tooyipjee/batlistener/Bat_Listner_JLCPCB/mfg/Rev A/schematic.pdf

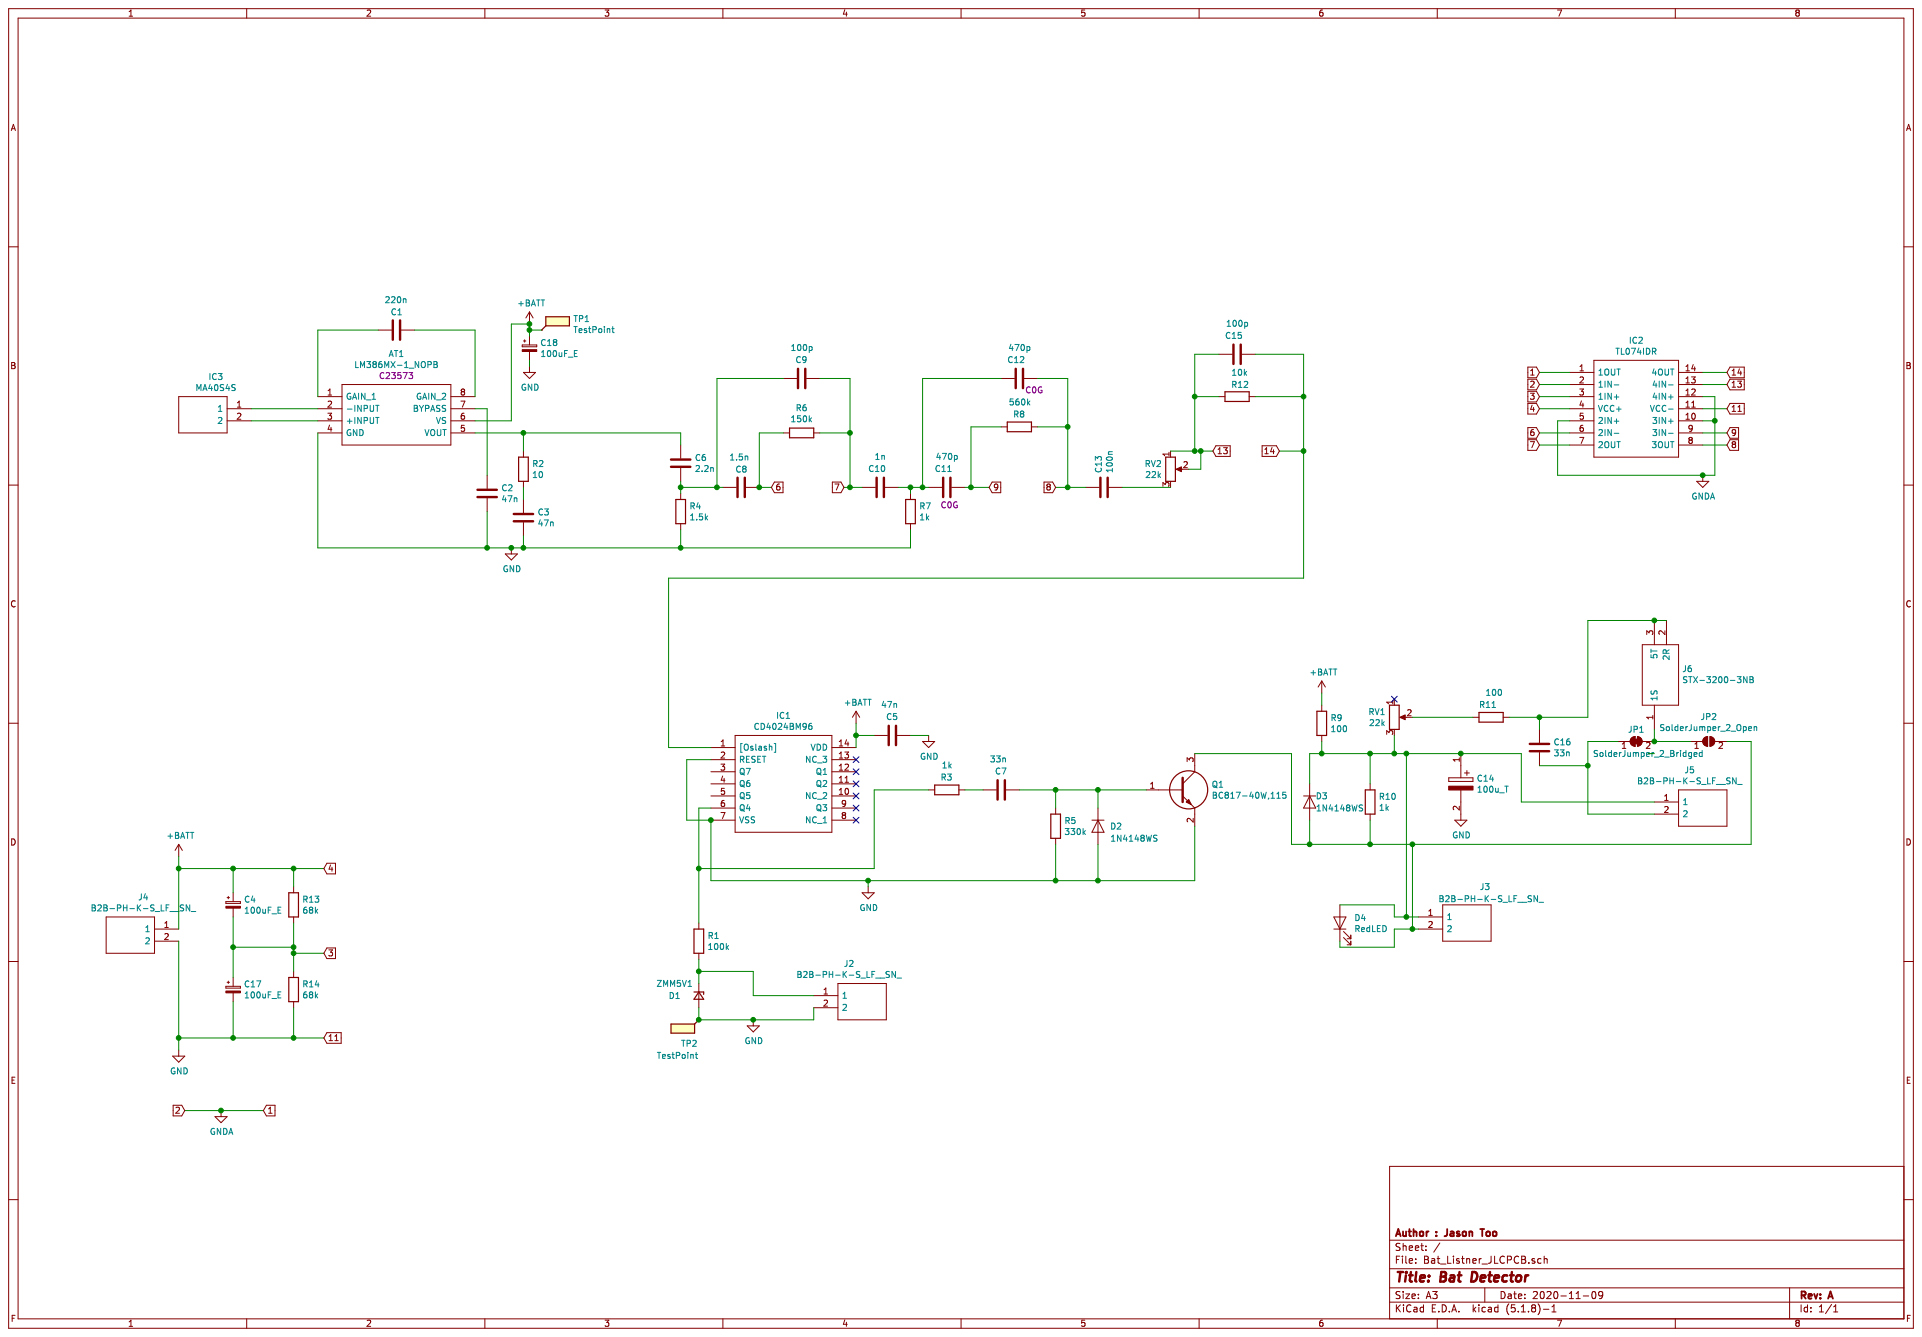
[picture p34: page 1]
