tooyipjee/batlistener/Bat_Listner_JLCPCB/mfg/Rev A/layout.pdf

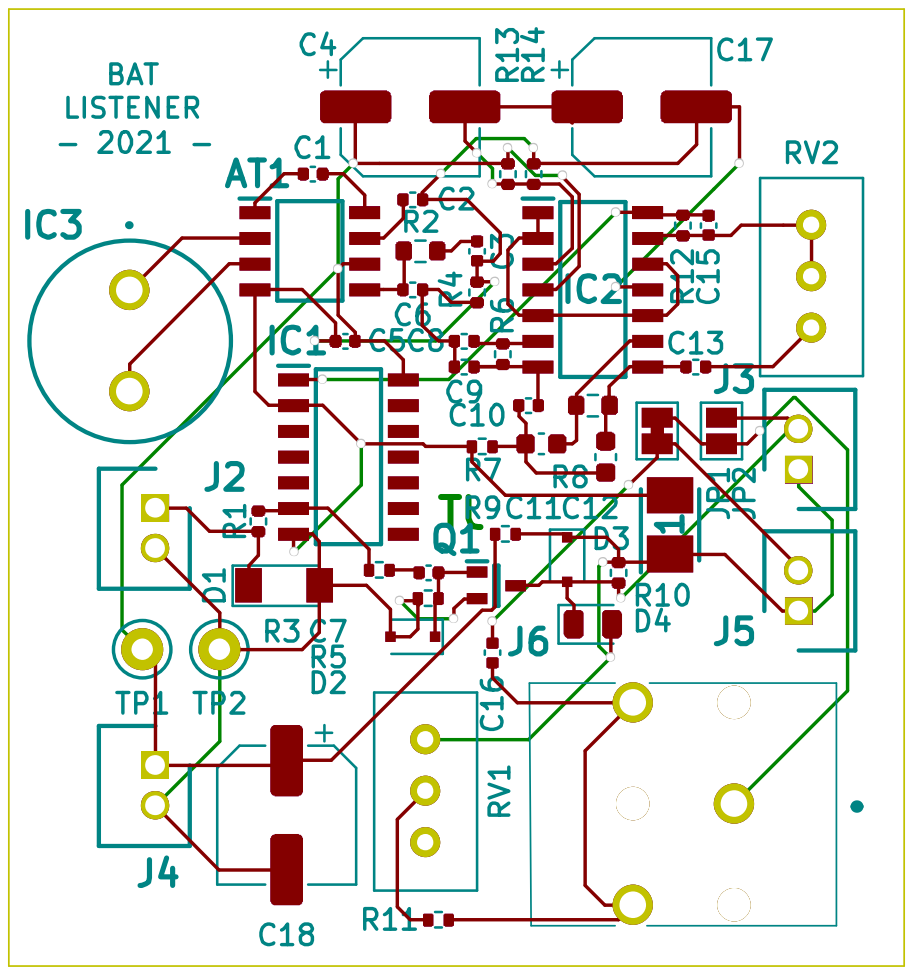
[picture p35: page 1]
