tooyipjee/batlistener/Bat_Listner_JLCPCB/Bat_Listner_JLCPCB.kicad_pcb

## KiCad design Bat_Listner_JLCPCB/Bat_Listner_JLCPCB.kicad_pcb (2021-05-26)

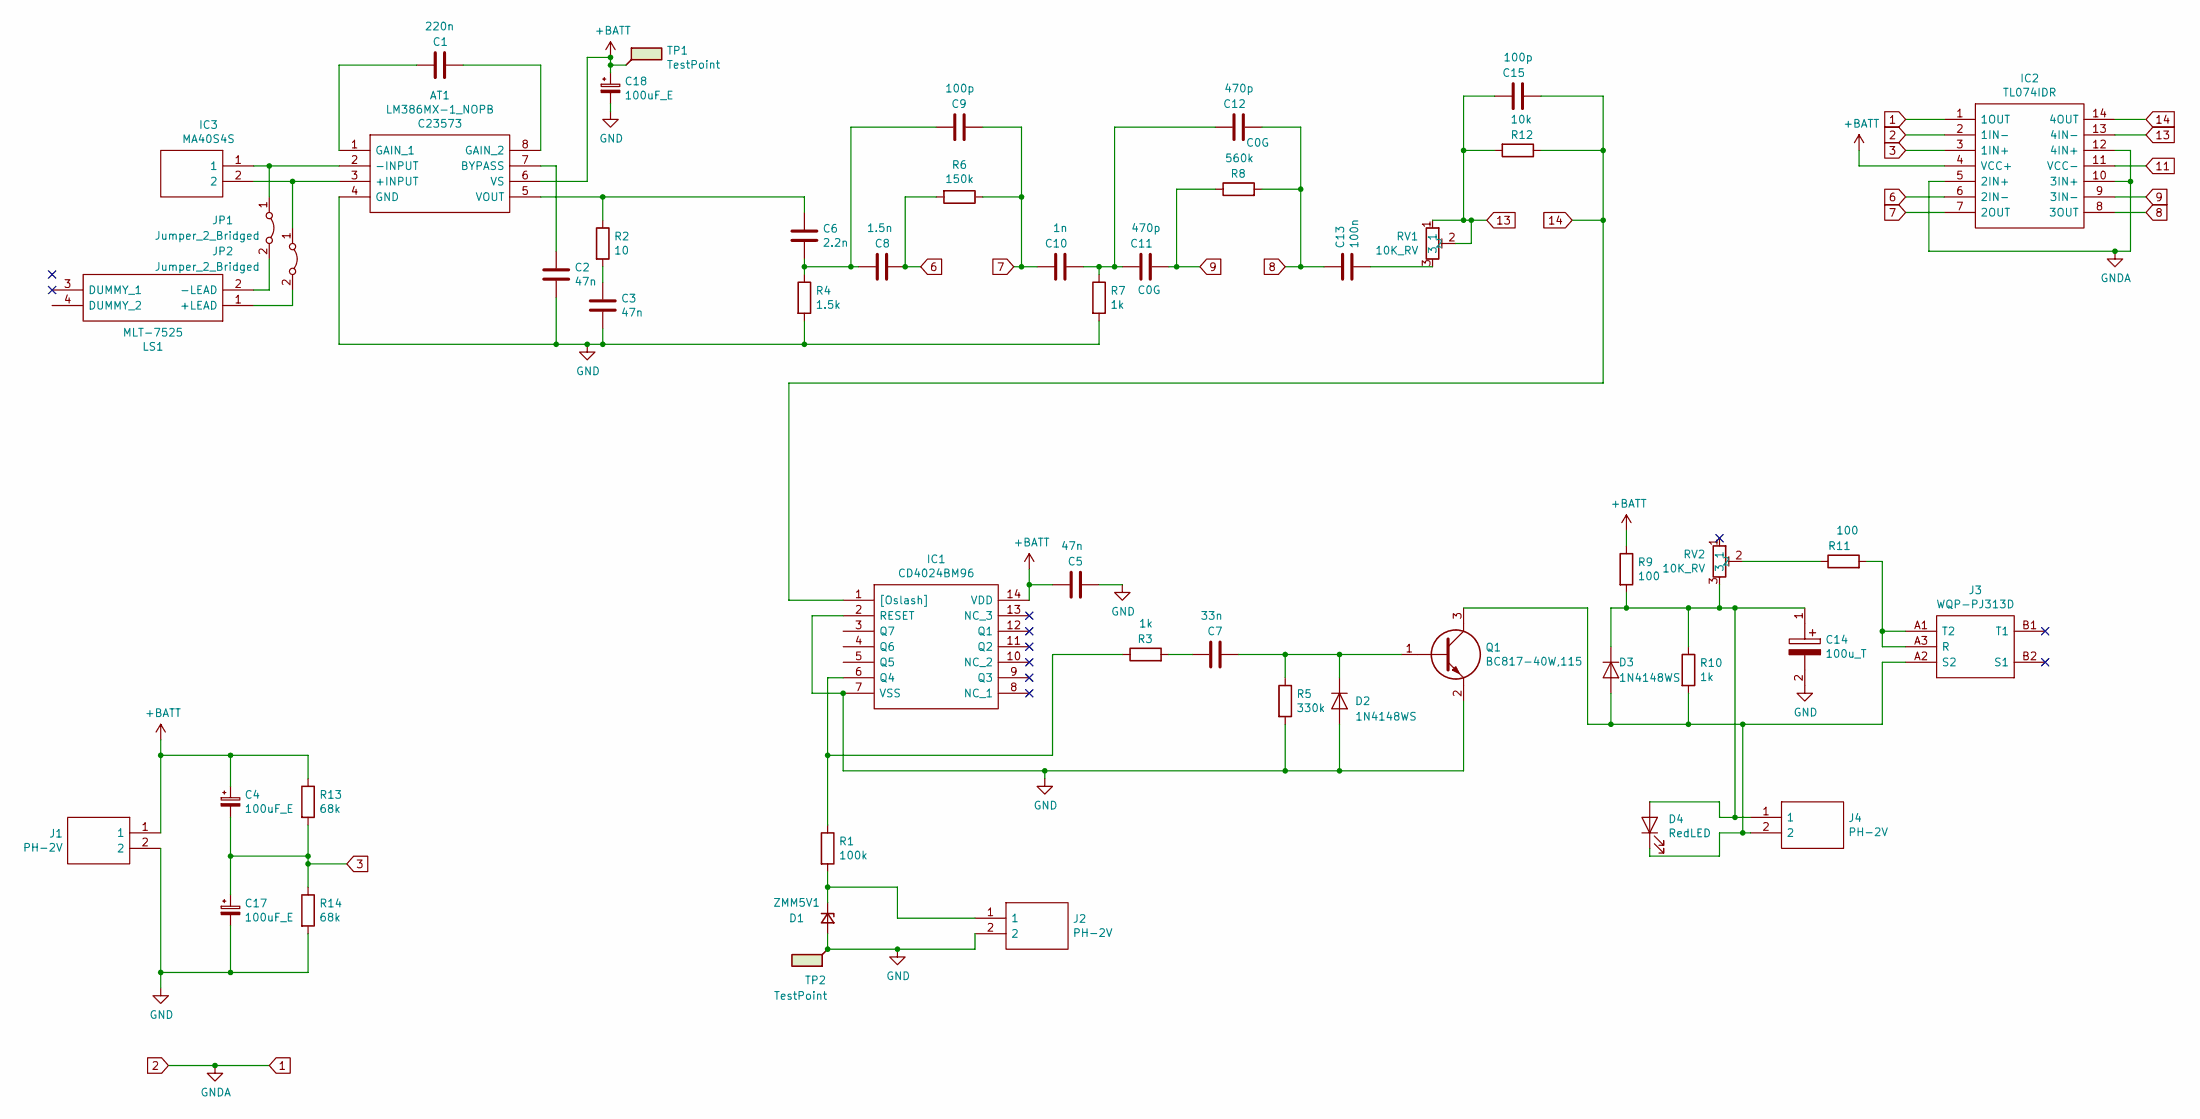
[picture p36: schematic Bat_Listner_JLCPCB.sch, Bat Detector]

Parts:
AT1: LM386MX-1_NOPB; SOIC127P600X175-8N; Manufacturer_Part_Number LM386MX-1/NOPB; Mouser Part Number 926-LM386MX-1/NOPB
C1: 220n; C_0402_1005Metric; LCSC C16772
C2, C3, C5: 47n; C_0402_1005Metric; LCSC C26403
C4, C17, C18: 100uF_E; CP_Elec_6.3x7.7; Rating 25V; LCSC C127971
C6: 2.2n; C_0402_1005Metric; LCSC C1531
C7: 33n; C_0402_1005Metric; LCSC C1585
C8: 1.5n; C_0402_1005Metric; LCSC C23967
C9, C15: 100p; C_0402_1005Metric; LCSC C1546
C10: 1n; C_0402_1005Metric; LCSC C1523
C11, C12: 470p; C_0603_1608Metric; Rating 25V; LCSC C1620
C13: 100n; C_0402_1005Metric; LCSC C307331
C14: 100u_T; CAPPM3528X210N; Mouser Part Number 581-TAJB107K006R
D1: ZMM5V1; D_MiniMELF; LCSC C8061
D2, D3: 1N4148WS; D_SOD-323F; LCSC C2128
D4: RedLED; D_0805_2012Metric; LCSC C84256
IC1: CD4024BM96; SOIC127P600X175-14N; Mouser Part Number 595-CD4024BM96
IC2: TL074IDR; SOIC127P600X175-14N; Manufacturer_Part_Number TL074IDR; Mouser Part Number 595-TL074IDR
IC3: MA40S4S; Mouser Part Number 81-MA40S4S
J1, J2, J4: PH-2V; SHDR2W52P0X200_1X2_600X460X630P; Manufacturer_Part_Number PH-2AK; Mouser Part Number 763-A2001WR2P
J3: WQP-PJ313D; C18167; Manufacturer_Part_Number C18167; LCSC C18167
JP1, JP2: Jumper_2_Bridged; SolderJumper-2_P1.3mm_Bridged_Pad1.0x1.5mm
LS1: MLT-7525; MLT7525; Manufacturer_Part_Number MLT-7525; LCSC C95299
Q1: BC817-40W,115; SOT65P210X110-3N; Manufacturer_Part_Number BC817-40W,115; Mouser Part Number 771-BC817-40W-T/R
R1: 100k; R_0402_1005Metric; LCSC C25741
R2: 10; R_0603_1608Metric; LCSC C25077
R3, R7, R10: 1k; R_0402_1005Metric; LCSC C11702
R4: 1.5k; R_0402_1005Metric; LCSC C25867
R5: 330k; R_0402_1005Metric; LCSC C25778
R6: 150k; R_0402_1005Metric; LCSC C25755
R8: 560k; R_0603_1608Metric; LCSC C23203
R9, R11: 100; R_0402_1005Metric; LCSC C25076
R12: 10k; R_0402_1005Metric; LCSC C25744
R13, R14: 68k; R_0402_1005Metric; LCSC C36871
RV1, RV2: 10K_RV; 3314J-1; Manufacturer_Part_Number 3314J-1-103E; Mouser Part Number 652-3314J-1-103E
TP1, TP2: TestPoint; TestPoint_Keystone_5000-5004_Miniature

Connections:
1: IC2.1 (1OUT), IC2.2 (1IN-), IC2.5 (2IN+), IC2.10 (3IN+), IC2.12 (4IN+)
3: C4.2, C17.1, IC2.3 (1IN+), R13.2, R14.1
6: C8.1, IC2.6 (2IN-), R6.2
7: C9.2, C10.1, IC2.7 (2OUT), R6.1
8: C12.2, C13.1, IC2.8 (3OUT), R8.2
9: C11.2, IC2.9 (3IN-), R8.1
13: C15.1, IC2.13 (4IN-), R12.2, RV1.1, RV1.2
14: C15.2, IC1.1 ([Oslash]), IC2.14 (4OUT), R12.1
+BATT: AT1.6 (VS), C4.1, C5.1, C18.1, IC1.14 (VDD), IC2.4 (VCC+), J1.1, R9.1, R13.1, TP1.1
GND: AT1.4 (GND), C2.2, C3.2, C5.2, C14.2, C17.2, C18.2, D1.2 (A), D2.2 (A), IC1.2 (RESET), IC1.7 (VSS), J1.2, J2.2, Q1.2, R4.2, R5.2, R7.2, R14.2, TP2.1
unnamed: AT1.1 (GAIN_1), C1.2
unnamed: AT1.2 (-INPUT), IC3.1, JP1.1 (A)
unnamed: AT1.3 (+INPUT), IC3.2, JP2.1 (A)
unnamed: AT1.5 (VOUT), C6.1, R2.1
unnamed: AT1.7 (BYPASS), C2.1
unnamed: AT1.8 (GAIN_2), C1.1
unnamed: C3.1, R2.2
unnamed: C6.2, C8.2, C9.1, R4.1
unnamed: C7.1, R3.2
unnamed: C7.2, D2.1 (K), Q1.1, R5.1
unnamed: C10.2, C11.1, C12.1, R7.1
unnamed: C13.2, RV1.3
unnamed: C14.1, D3.1 (K), D4.2 (A), J4.1, R9.2, R10.1, RV2.3
unnamed: D1.1 (K), J2.1, R1.2
unnamed: D3.2 (A), D4.1 (K), J3.A2 (S2), J4.2, Q1.3, R10.2
unnamed: IC1.6 (Q4), R1.1, R3.1
unnamed: J3.A1 (T2), J3.A3 (R), R11.2
unnamed: JP1.2 (B), LS1.2 (-LEAD)
unnamed: JP2.2 (B), LS1.1 (+LEAD)
unnamed: R11.1, RV2.2

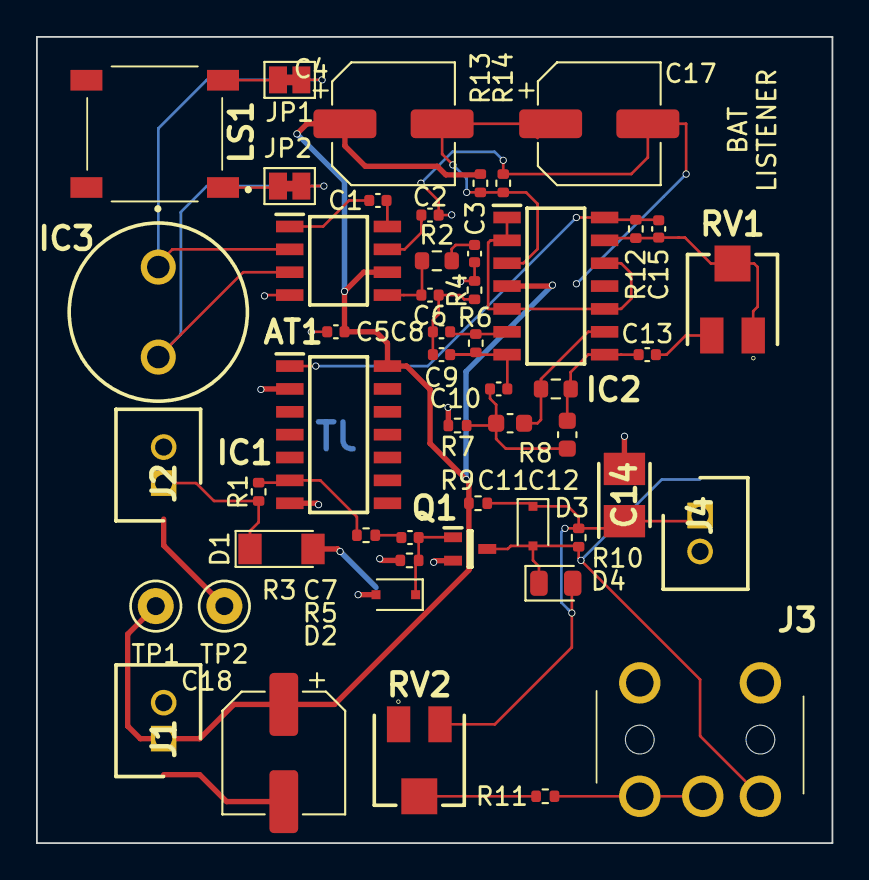
[picture p37: board Bat_Listner_JLCPCB.kicad_pcb from above]

Board: 2 copper layers, 44.2 x 44.8 mm, 51 parts (0 on the bottom side), 30 nets.
