tooyipjee/batlistener/(commit log)

2020-10-25 Created file for bat detector
    [Bat_Listner_JLCPCB.kicad_pcb, Bat_Listner_JLCPCB.sch]
2020-11-09 Preliminary part placement
    [Bat_Listner_JLCPCB.sch]
2020-12-27 Finished schematic
    [Bat_Listner_JLCPCB.kicad_pcb, Bat_Listner_JLCPCB.sch]
2021-01-01 prelim layout with TPs
    [Bat_Listner_JLCPCB.kicad_pcb, Bat_Listner_JLCPCB.sch]
2021-01-05 finished layout
    [Bat_Listner_JLCPCB.kicad_pcb, Bat_Listner_JLCPCB.sch]
2021-01-14 Finished PCB
    [Bat_Listner_JLCPCB.kicad_pcb]
2021-01-15 completed wiring
    [Bat_Listner_JLCPCB-B_Cu.gbr, Bat_Listner_JLCPCB-B_Mask.gbr, Bat_Listner_JLCPCB-B_Paste.gbr, Bat_Listner_JLCPCB-B_SilkS.gbr, Bat_Listner_JLCPCB-Edge_Cuts.gbr, Bat_Listner_JLCPCB-F_Cu.gbr, Bat_Listner_JLCPCB-F_Mask.gbr, Bat_Listner_JLCPCB-F_Paste.gbr]
2021-01-31 updated pcb to fix audio jack
    [Bat_Listner_JLCPCB.kicad_pcb, Bat_Listner_JLCPCB.sch]
2021-02-05 updated design
    [Bat_Listner_JLCPCB.kicad_pcb, Bat_Listner_JLCPCB.sch]
2021-02-07 update mfg
    [Bat_Listner_JLCPCB-B_Cu.gbr, Bat_Listner_JLCPCB-B_Mask.gbr, Bat_Listner_JLCPCB-B_Paste.gbr, Bat_Listner_JLCPCB-B_SilkS.gbr, Bat_Listner_JLCPCB-Edge_Cuts.gbr, Bat_Listner_JLCPCB-F_Cu.gbr, Bat_Listner_JLCPCB-F_Mask.gbr, Bat_Listner_JLCPCB-F_Paste.gbr]
